grodansparadis/zeus_expansion_roma/README.md

<h1>Zeus Expansion Roma</h1>



433Mhz RF add on card with Zeus expansion connector. Fits the 
<a href="http://www.grodansparadis.com/odessa/odessa.html">Odessa</a> module
among other modules.
