grodansparadis/zeus_expansion_roma/eagle/Gerbers/roma_rev_b_specification.txt

Ake Hedman
Grodans Paradis AB

Date:				2014-06-18
Part Number: 		Roma
Number of boards: 	120
Number of layers: 	2
Material: 			FR4
Final Thickness:	1.6 mm
Final copper:		1/1oz
Surface treatment: 	ENIG
Unit Size:			41x49
Panel Size:		
Unit/panel:			6
Solder Mask:		Black
Silk Screen: 		White	
Outline Profile:	CNC Routing + V-cut
X-out Allowed:		1
Stencil needed:		yes
Gerber layer for Stencil: Component Cream (pmc)

Note: Solder silk (pls) can be ignored.
