grodansparadis/zeus_expansion_roma/eagle/roma_sch1_rev_B.png

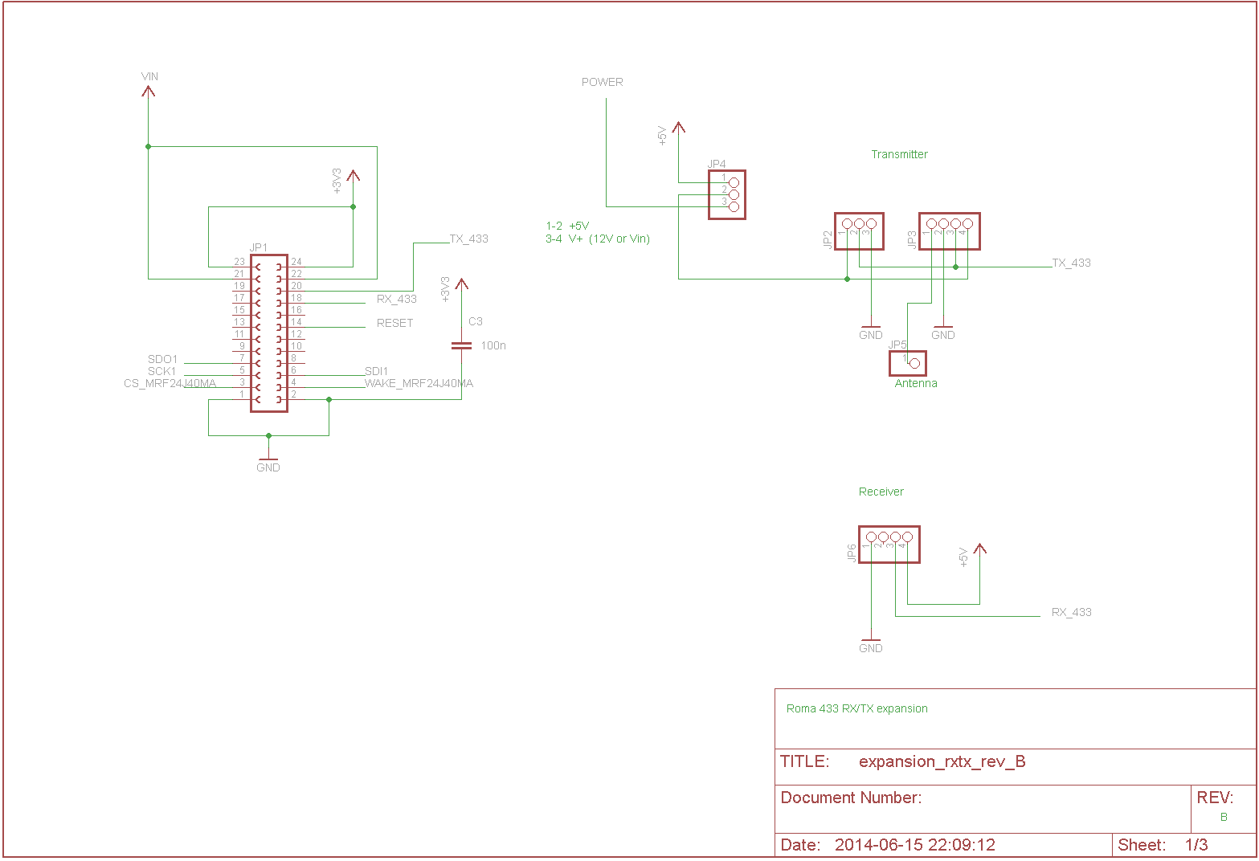
eagle/roma_sch1_rev_B.png
