grodansparadis/zeus_expansion_roma/eagle/Gerbers/roma_expansion_rxtx_rev_b panel.pdf

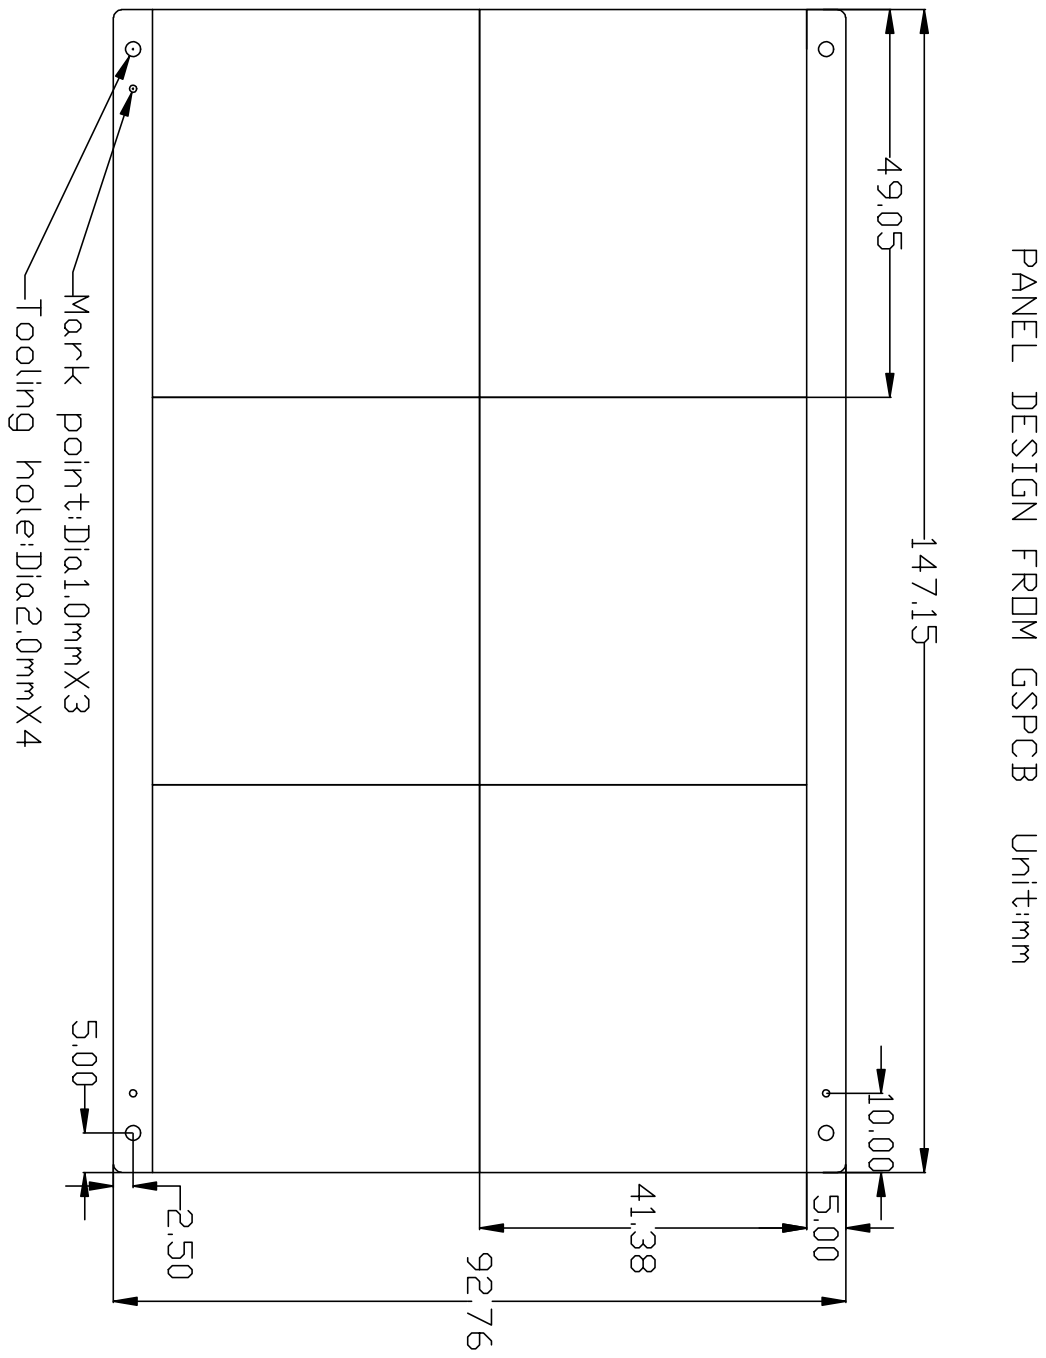
[picture p4: page 1]
