grodansparadis/zeus_expansion_roma/eagle/roma_rev_c.brd

## EAGLE design eagle/roma_rev_c.brd (2015-12-30)

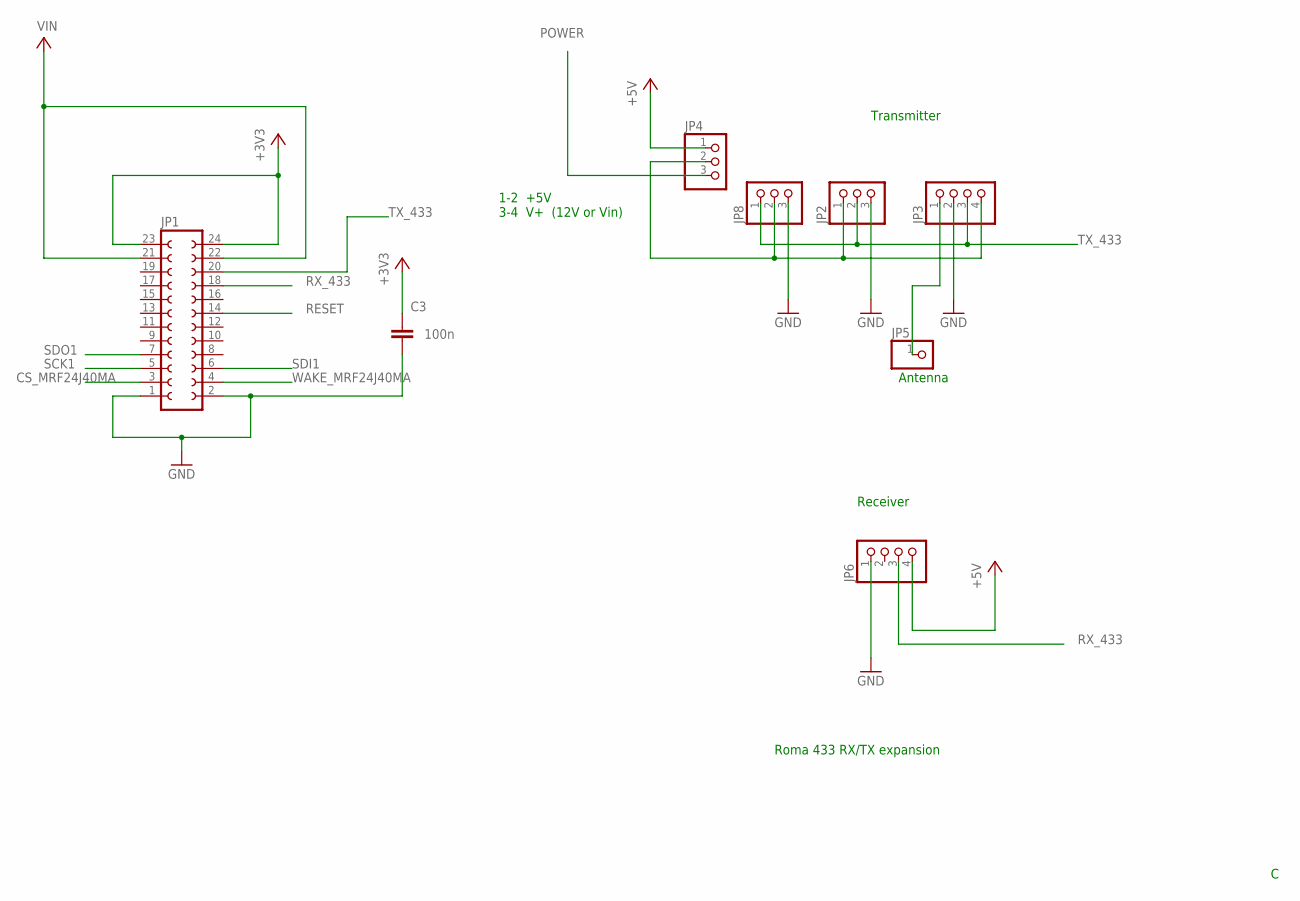
[picture p5: schematic roma_rev_c.sch, sheet 1]

Parts:
C3: 100n; C0805
JP1: FE12-2
JP2, JP4, JP8: PINHD-1X3; 1X03
JP3, JP6: PINHD-1X4; 1X04
JP5: PINHD-1X1; 1X01

Connections:
+3V3: C3.1, JP1.23, JP1.24; also elsewhere on the board
+5V: JP4.1, JP6.4; also elsewhere on the board
CS_MRF24J40MA: JP1.3; also elsewhere on the board
GND: C3.2, JP1.1, JP1.2, JP2.3, JP3.2, JP6.1, JP8.3; also elsewhere on the board
unnamed: JP2.1, JP3.4, JP4.2, JP8.2
unnamed: JP3.1, JP5.1
POWER: JP4.3; also elsewhere on the board
RESET: JP1.14; also elsewhere on the board
RX_433: JP1.18, JP6.3; also elsewhere on the board
SCK1: JP1.5; also elsewhere on the board
SDI1: JP1.6; also elsewhere on the board
SDO1: JP1.7; also elsewhere on the board
TX_433: JP1.20, JP2.2, JP3.3, JP8.1
VIN: JP1.21, JP1.22; also elsewhere on the board
WAKE_MRF24J40MA: JP1.4; also elsewhere on the board

Notes on the sheet:
Roma 433 RX/TX expansion
Transmitter
Antenna
Receiver
1-2 +5V 3-4 V+ (12V or Vin)

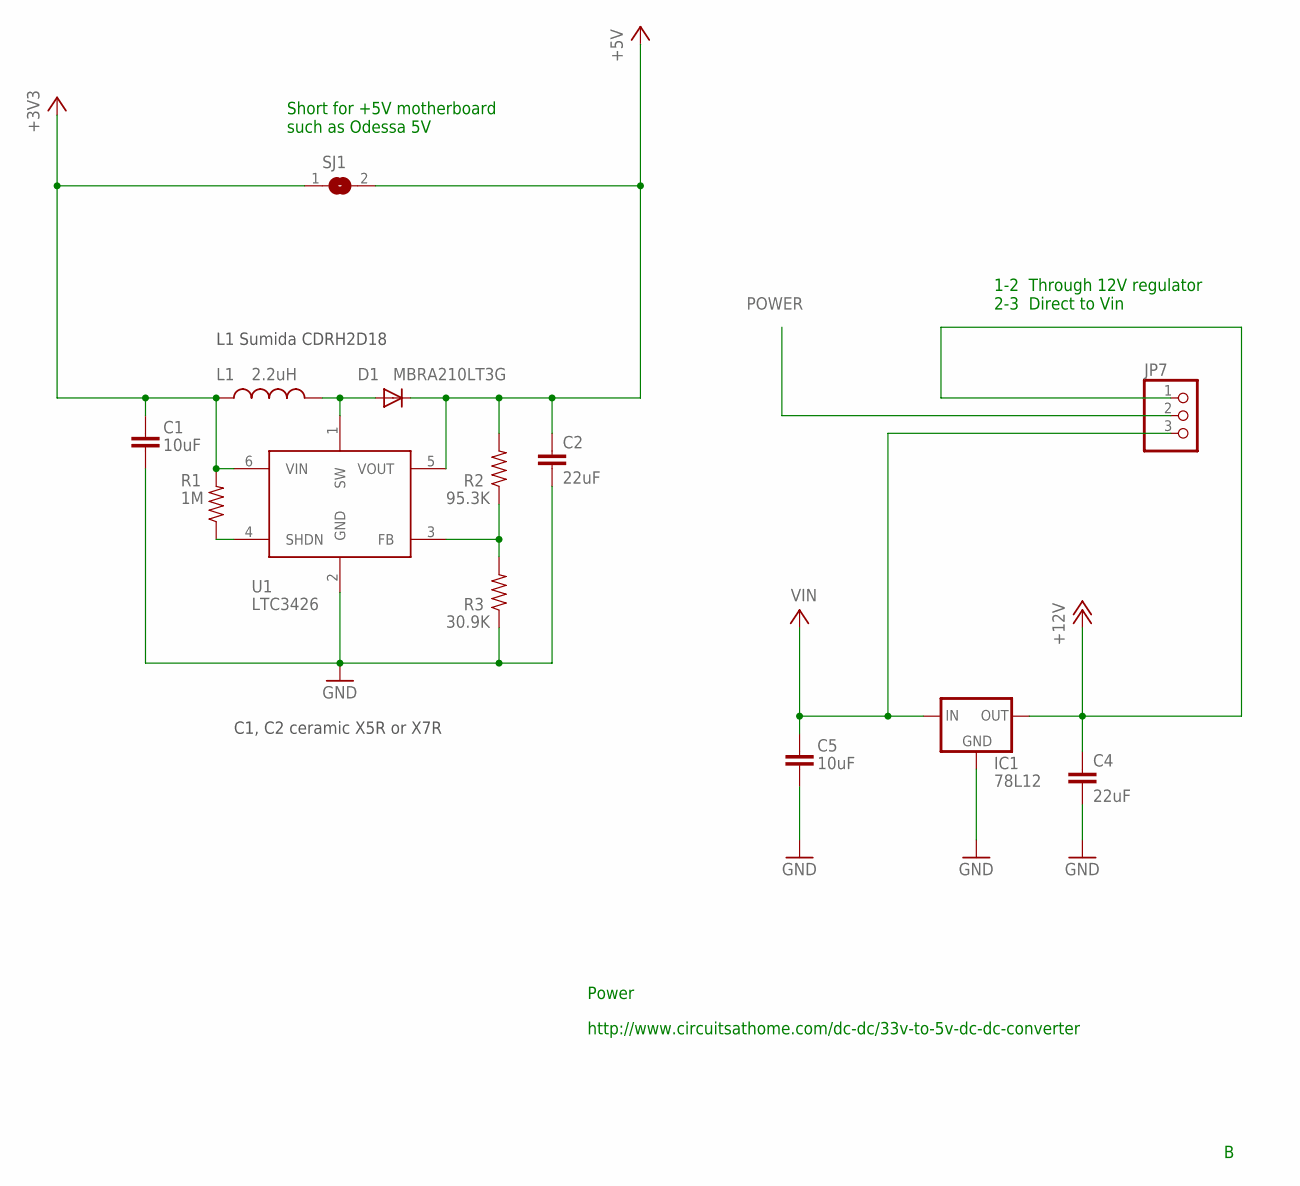
[picture p6: schematic roma_rev_c.sch, sheet 2]

Parts:
C1, C5: 10uF; 1210
C2, C4: 22uF; 1210
D1: MBRA210LT3G; SMA-DIODE
IC1: 78L12; 78LXX
JP7: PINHD-1X3; 1X03
L1: 2.2uH; 1_3X1_3
R1: 1M; 0805
R2: 95.3K; 0805
R3: 30.9K; 0805
SJ1: SJ
U1: LTC3426; SOT23-6

Connections:
+3V3: C1.1, L1.P$1 (1), R1.2, SJ1.1, U1.6 (VIN); also elsewhere on the board
+5V: C2.1, D1.C, R2.2, SJ1.2, U1.5 (VOUT); also elsewhere on the board
+12V: C4.1, IC1.OUT, JP7.1
GND: C1.2, C2.2, C4.2, C5.2, IC1.GND, R3.1, U1.2 (GND); also elsewhere on the board
unnamed: D1.A, L1.P$2 (2), U1.1 (SW)
unnamed: R1.1, U1.4 (SHDN)
unnamed: R2.1, R3.2, U1.3 (FB)
POWER: JP7.2; also elsewhere on the board
VIN: C5.1, IC1.IN, JP7.3; also elsewhere on the board

Notes on the sheet:
L1 Sumida CDRH2D18
C1, C2 ceramic X5R or X7R
http://www.circuitsathome.com/dc-dc/33v-to-5v-dc-dc-converter
Power
1-2 Through 12V regulator 2-3 Direct to Vin
Short for +5V motherboard such as Odessa 5V

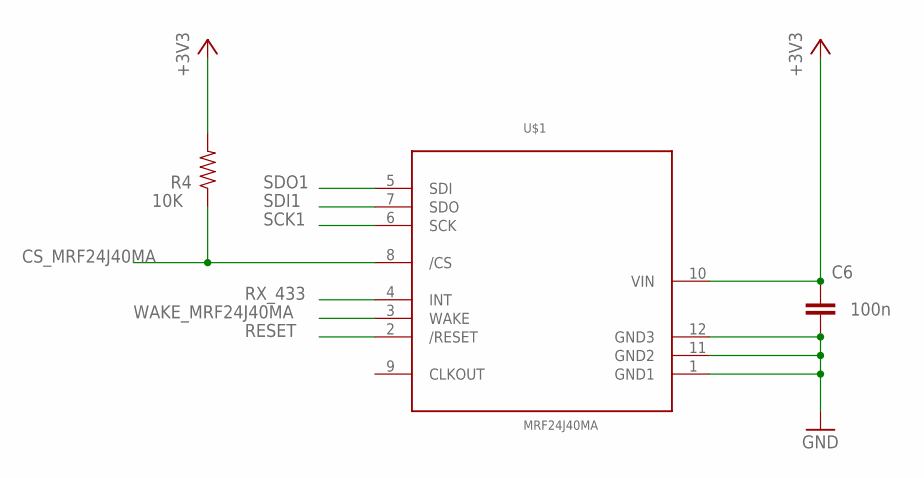
[picture p7: schematic roma_rev_c.sch, sheet 3]

Parts:
C6: 100n; C0805
R4: 10K; 0805
U$1: MRF24J40MA

Connections:
+3V3: C6.1, R4.2, U$1.10 (VIN); also elsewhere on the board
CS_MRF24J40MA: R4.1, U$1.8 (/CS); also elsewhere on the board
GND: C6.2, U$1.1 (GND1), U$1.11 (GND2), U$1.12 (GND3); also elsewhere on the board
RESET: U$1.2 (/RESET); also elsewhere on the board
RX_433: U$1.4 (INT); also elsewhere on the board
SCK1: U$1.6 (SCK); also elsewhere on the board
SDI1: U$1.7 (SDO); also elsewhere on the board
SDO1: U$1.5 (SDI); also elsewhere on the board
WAKE_MRF24J40MA: U$1.3 (WAKE); also elsewhere on the board

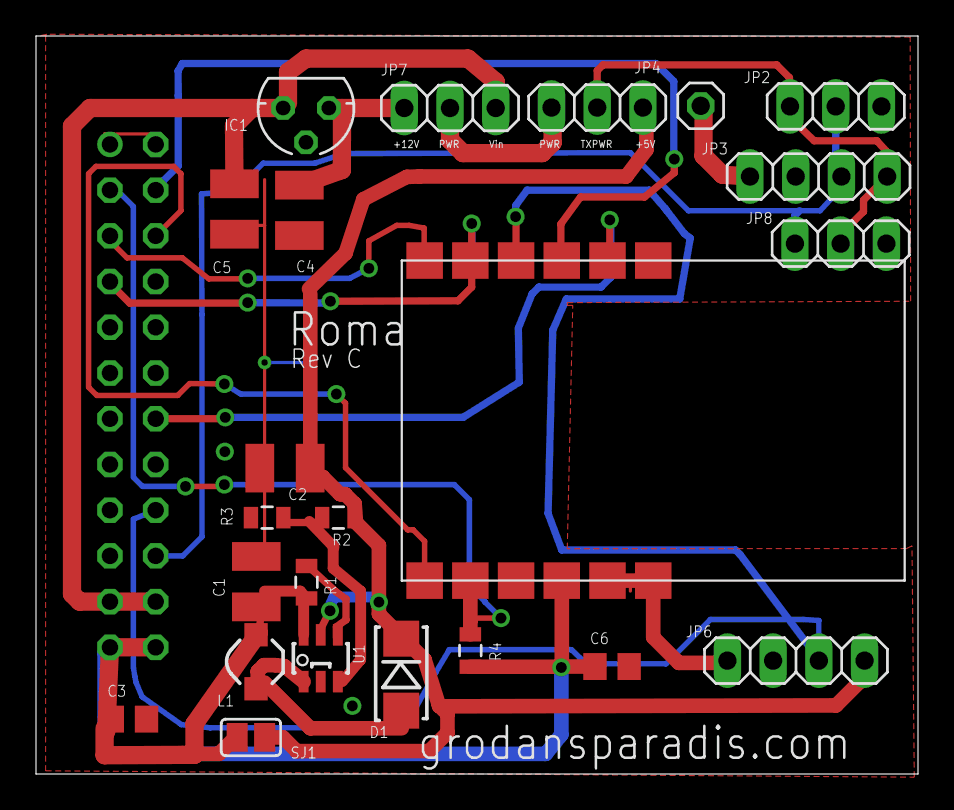
[picture p8: board roma_rev_c.brd from above]

Board: 2 copper layers, 49.0 x 41.0 mm, 24 parts (1 on the bottom side), 19 nets.
