grodansparadis/zeus_expansion_roma/HISTORY.txt

2015-12-30 - Added solder short to get +5V from Odessa 5V without converter.
2015-12-30 - JP4 should be numbered the other way around. Added descriptive text.
2015-12-30 - Added new pinning for transmitter module J8
2015-12-30 - Reversion C
2014-06-18 - AKHE Off to factory
2014-06-15 - AKHE Rev B ready
