grodansparadis/zeus_expansion_roma/(commit log)

2015-11-03 Making design open
    [dcdc3to5.brd, dcdc3to5.sch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]
2015-11-03 Removed some junk
    [expansion_mrf24j40ma.brd, expansion_mrf24j40ma.sch, expansion_rxtx.brd, expansion_rxtx.sch, expansion_rxtx_rev_b.brd, expansion_rxtx_rev_b.sch, expansion_rxtx_reva.brd, expansion_rxtx_reva.sch]
2015-11-18 Moving old stuff out
    [expansion_mrf24j40ma.brd, expansion_mrf24j40ma.sch, expansion_rxtx.brd, expansion_rxtx.sch, expansion_rxtx_rev_b.brd, expansion_rxtx_rev_b.sch, expansion_rxtx_reva.brd, expansion_rxtx_reva.sch]
2015-11-18 Renamed schemas to be consistent
    [roma_rev_b.brd, roma_rev_b.sch]
2015-11-18 Moved some old files
    [expansion_mrf24j40ma.brd, expansion_mrf24j40ma.sch, expansion_rxtx.brd, expansion_rxtx.sch, expansion_rxtx_rev_b.brd, expansion_rxtx_rev_b.sch, expansion_rxtx_reva.brd, expansion_rxtx_reva.sch]
2015-12-30 Added new transmitter pinout
    [roma_rev_c.brd, roma_rev_c.sch]
2015-12-30 JP4 should be numbered the other way around. Added descriptive text.
    [roma_rev_c.brd]
2015-12-30 Added solder short to get +5V from Odessa 5V without converter.
    [roma_rev_c.brd, roma_rev_c.sch]
2015-12-30 Redrawn signal that goes over transceiver protected zone
    [roma_rev_c.brd, roma_rev_c.sch]
